universalgeek56/UG56-Smart-UPS/img/03_breadboard2.jpg

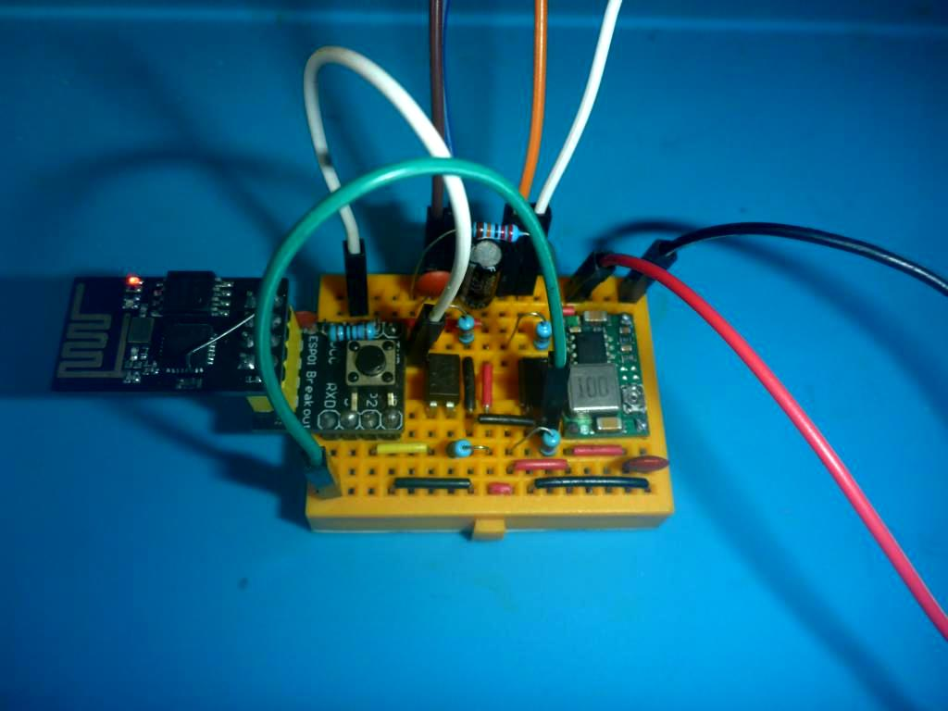
img/03_breadboard2.jpg
