universalgeek56/UG56-Smart-UPS/img/3D_PCB1_1_2026-02-25 (1).png

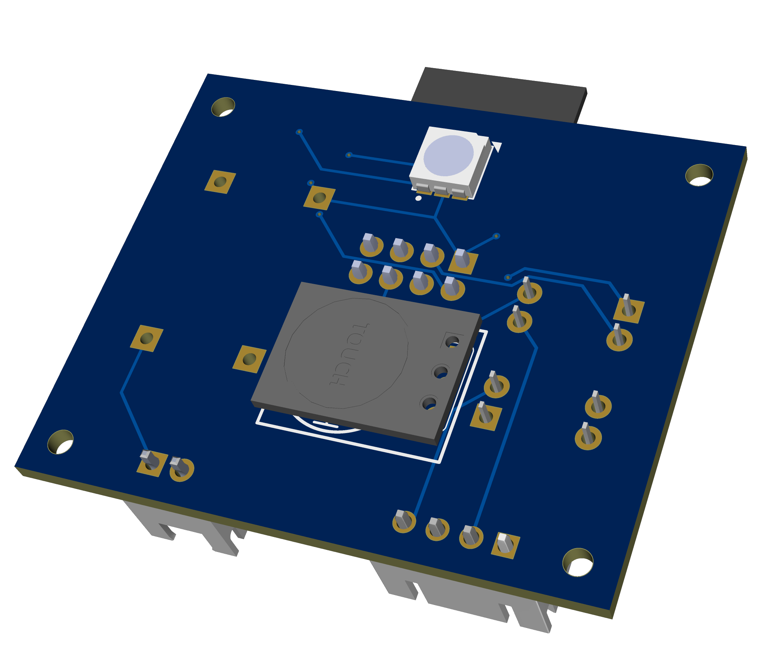
img/3D_PCB1_1_2026-02-25 (1).png
