universalgeek56/UG56-Smart-UPS/img/Screenshot.png

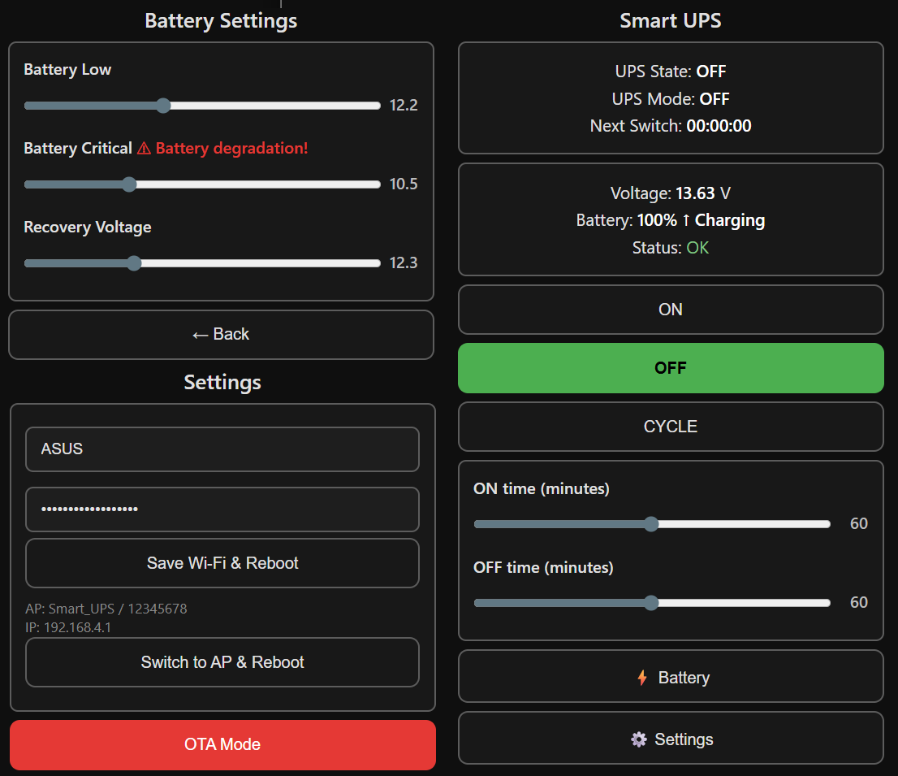
img/Screenshot.png
