universalgeek56/UG56-Smart-UPS/img/04_soldered3.jpg

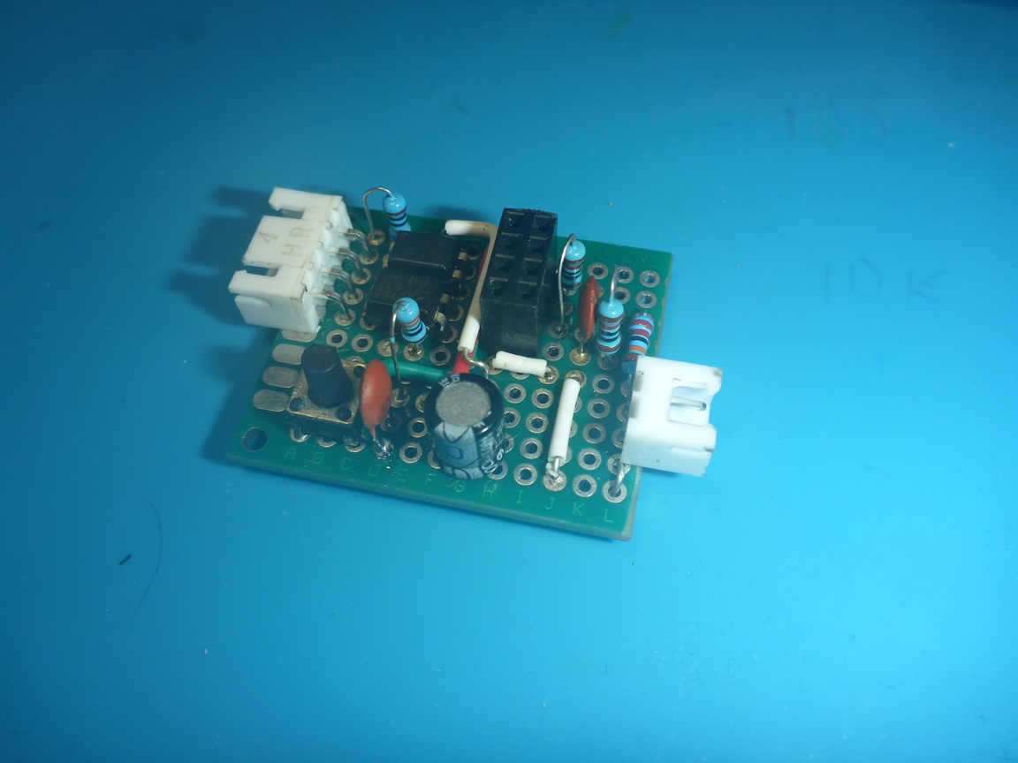
img/04_soldered3.jpg
