universalgeek56/UG56-Smart-UPS/img/04_soldered5.jpg

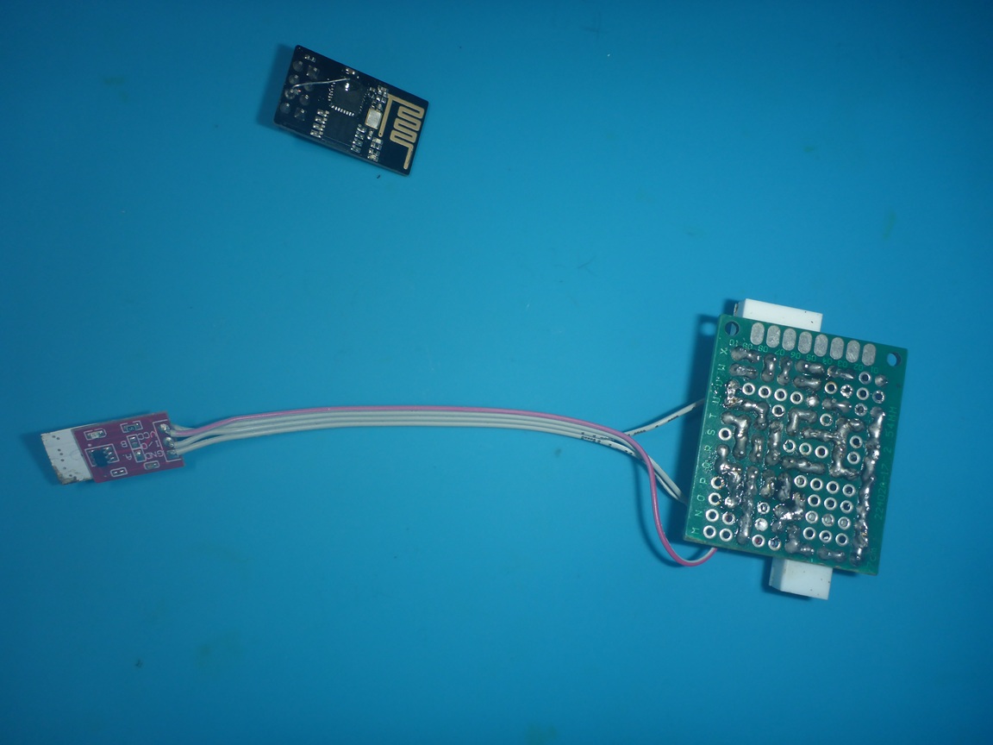
img/04_soldered5.jpg
