universalgeek56/UG56-Smart-UPS/img/04_soldered6.jpg

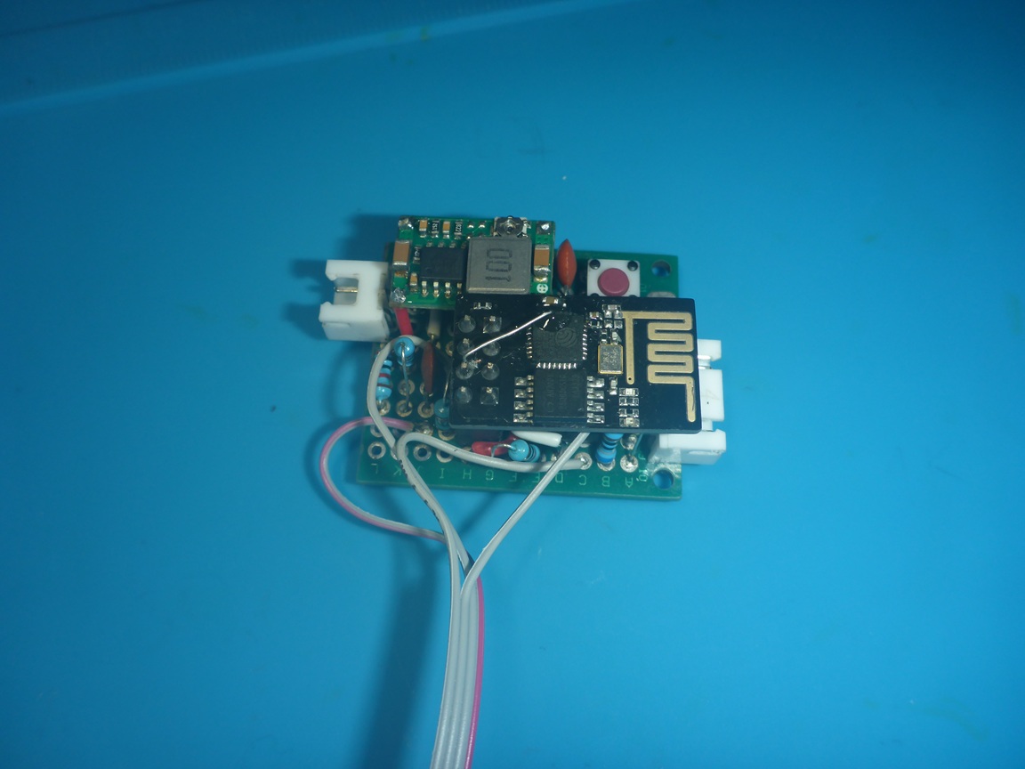
img/04_soldered6.jpg
