universalgeek56/UG56-Smart-UPS/img/05_installed2.jpg

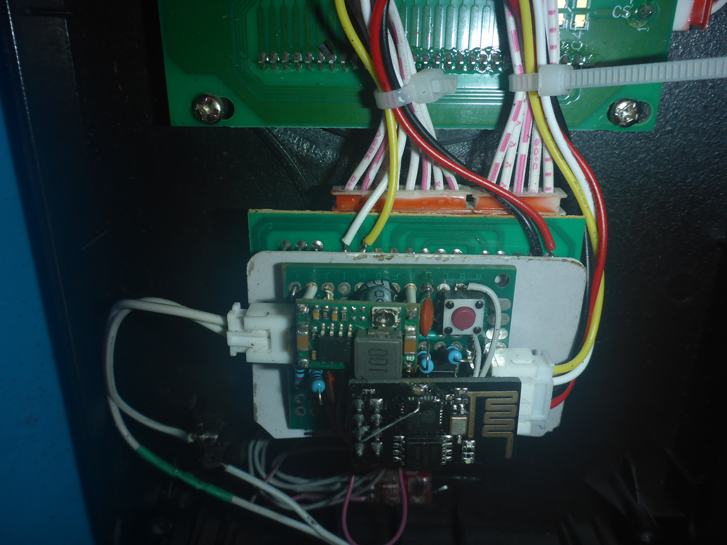
img/05_installed2.jpg
