universalgeek56/UG56-Smart-UPS/img/05_installed.jpg

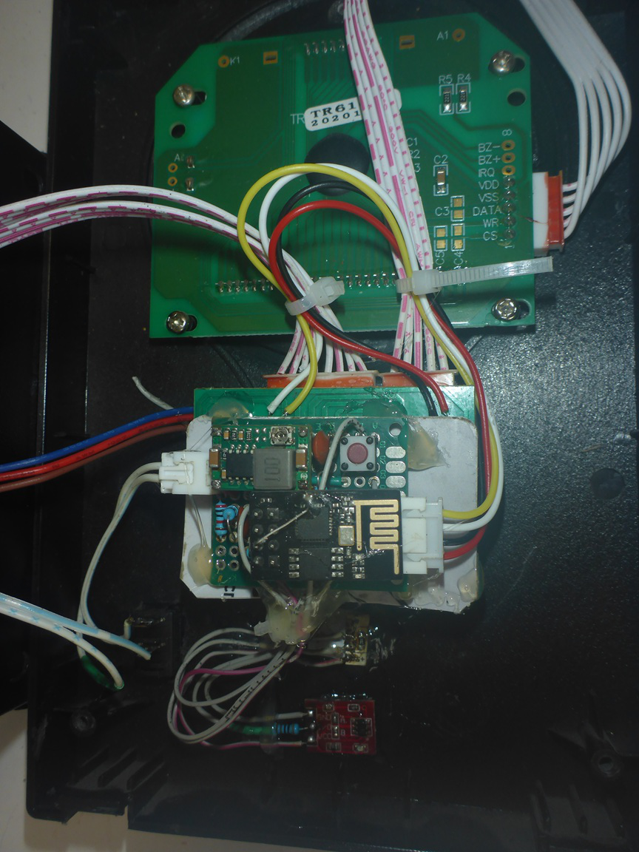
img/05_installed.jpg
