universalgeek56/UG56-Smart-UPS/img/06_ADCcalibration.png

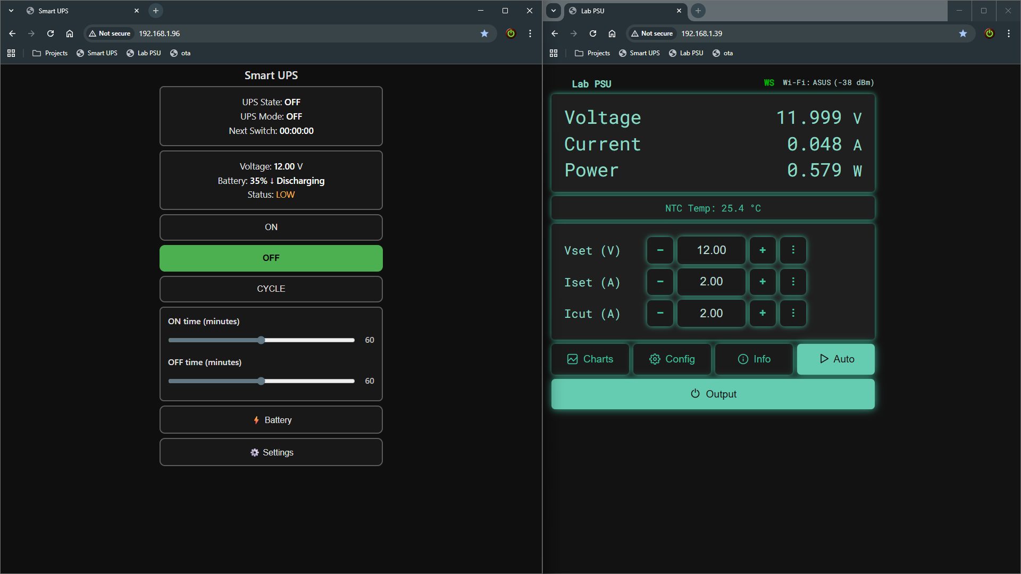
img/06_ADCcalibration.png
