universalgeek56/UG56-Smart-UPS/src/Globals.cpp

#include "Globals.h"

/* DEVICE */
char deviceName[16] = "UG-UPS";

/* WIFI */
bool wifiEnabled   = true;
bool wifiConnected = false;

char wifiApSSID[32]  = "Smart_UPS";
char wifiApPass[16]  = "12345678";
